AmilaChinthaka97/Analog-Line-Follower/Photos/IMG-20190604-WA0003.jpg

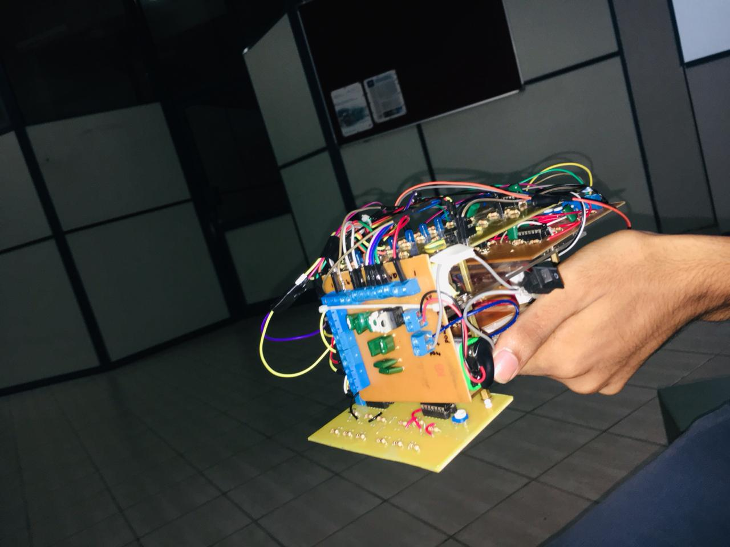
Photos/IMG-20190604-WA0003.jpg
