AmilaChinthaka97/Analog-Line-Follower/Photos/IMG-20190604-WA0004.jpg

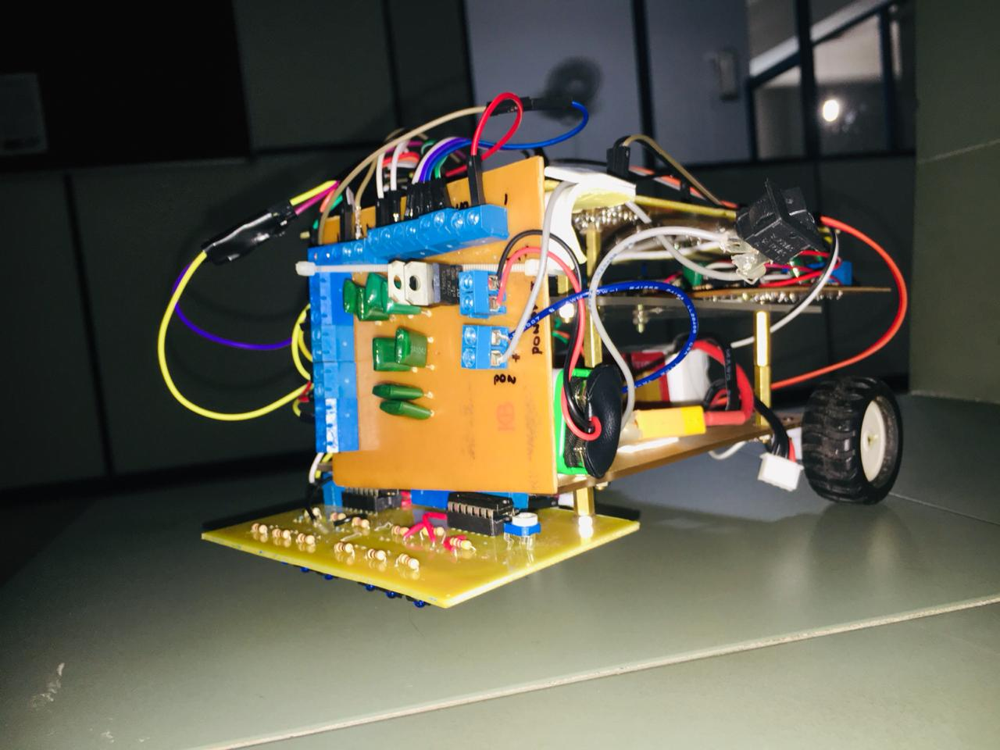
Photos/IMG-20190604-WA0004.jpg
