AmilaChinthaka97/Analog-Line-Follower/Photos/IMG-20190604-WA0016.jpg

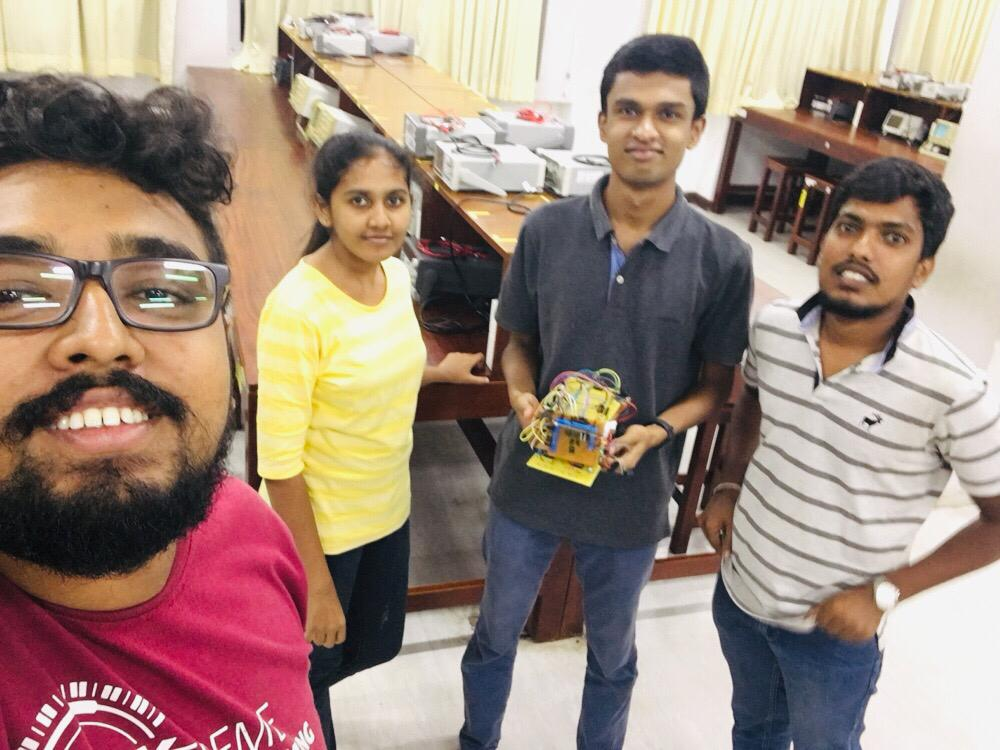
Photos/IMG-20190604-WA0016.jpg
