AmilaChinthaka97/Analog-Line-Follower/Photos/IMG-20190605-WA0002.jpg

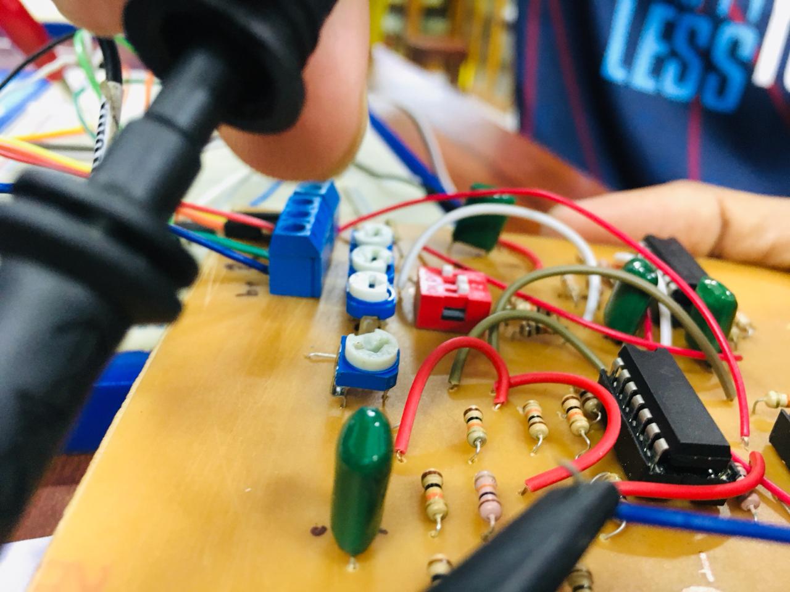
Photos/IMG-20190605-WA0002.jpg
