AmilaChinthaka97/Analog-Line-Follower/Photos/IMG-20190605-WA0006.jpg

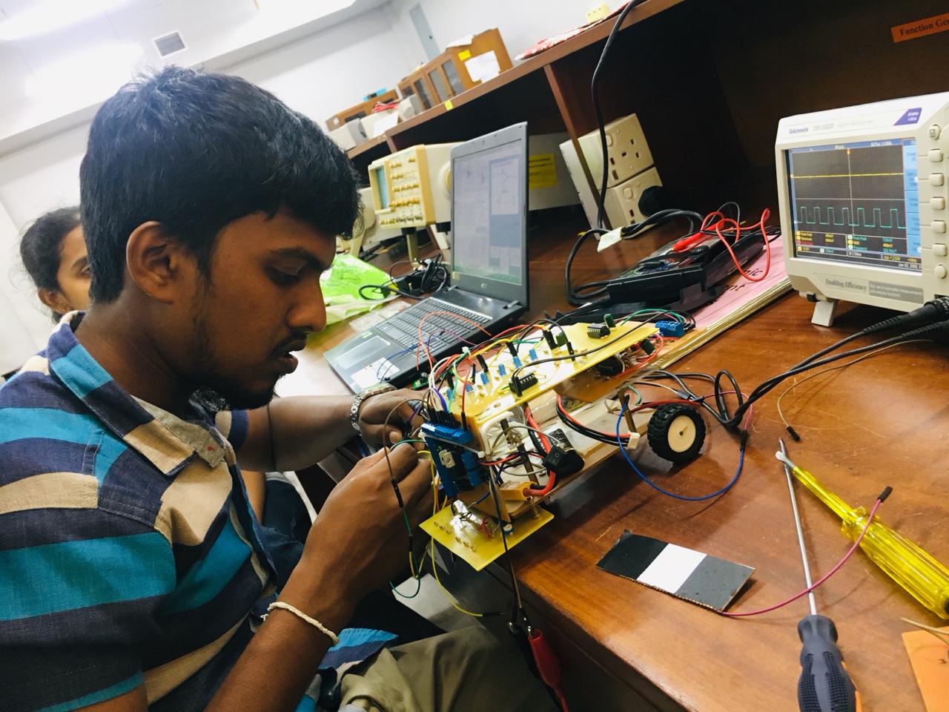
Photos/IMG-20190605-WA0006.jpg
