AmilaChinthaka97/Analog-Line-Follower/PCB Layouts/Error_TraingleWave.pdf

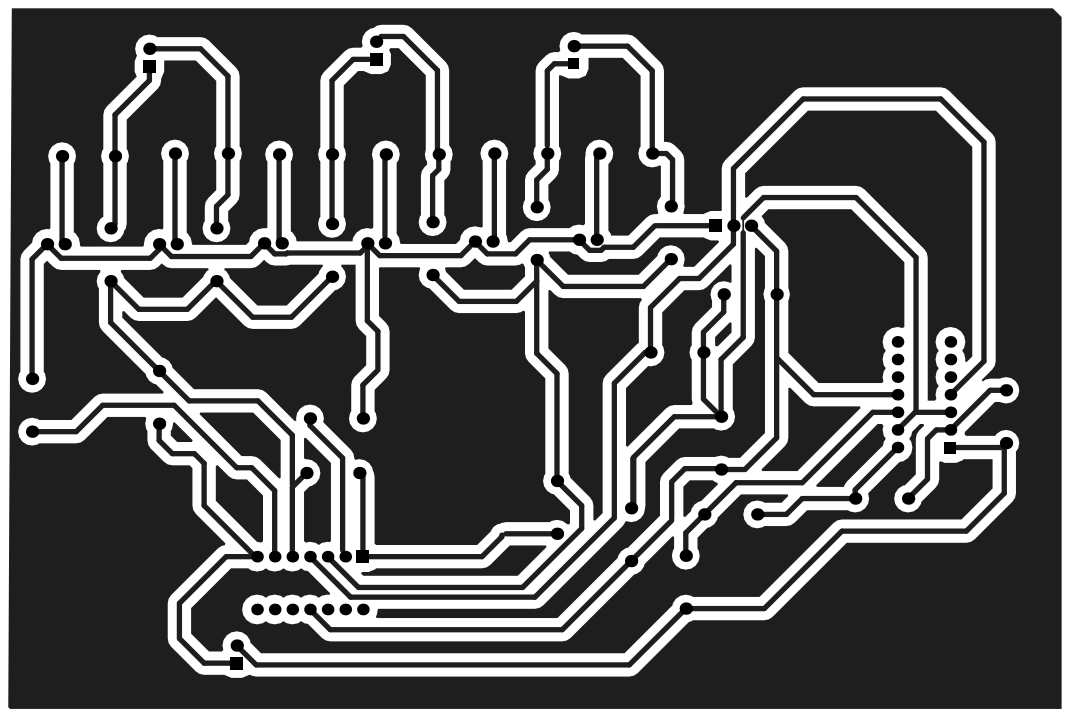
[picture p32: page 1]
