AmilaChinthaka97/Analog-Line-Follower/PCB Layouts/PID_All_New_Scaled.pdf

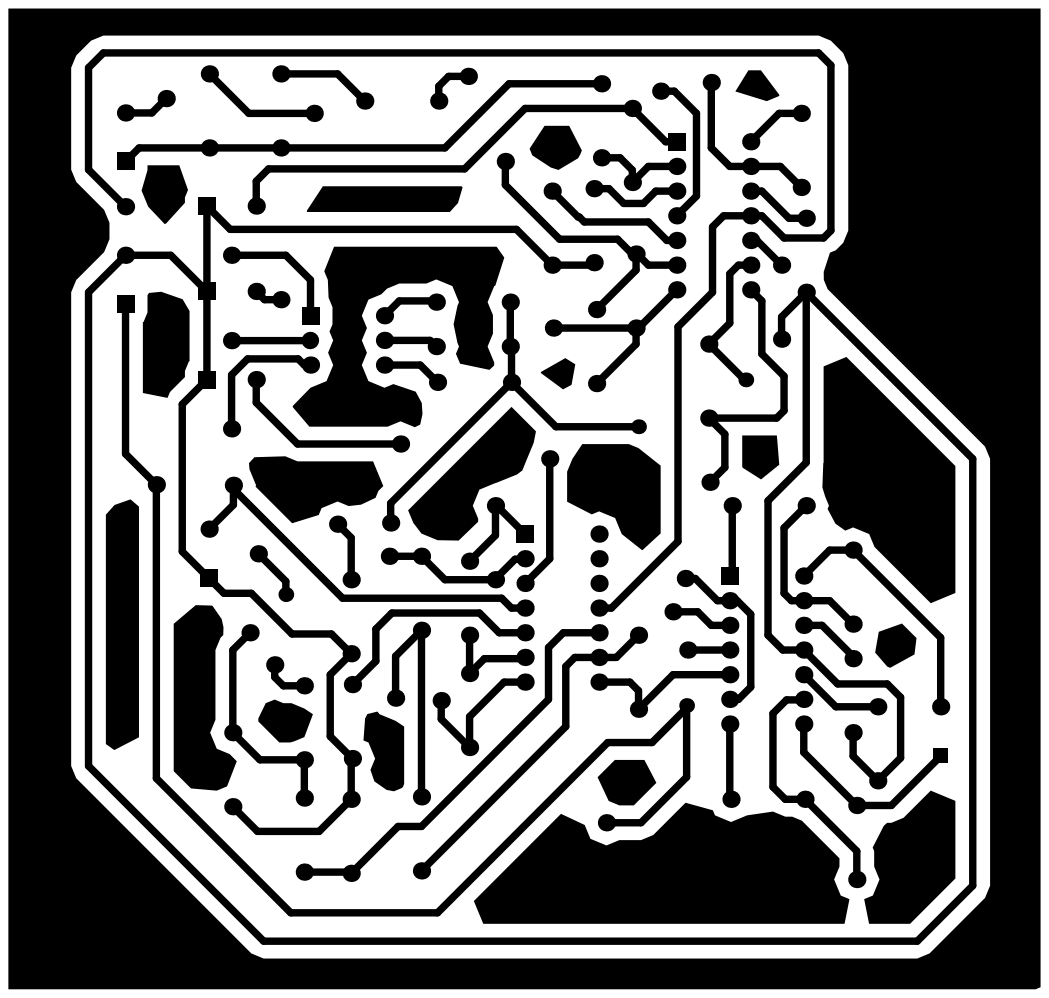
[picture p33: page 1]
