AmilaChinthaka97/Analog-Line-Follower/PCB Layouts/Power_Supply_With_Holes.pdf

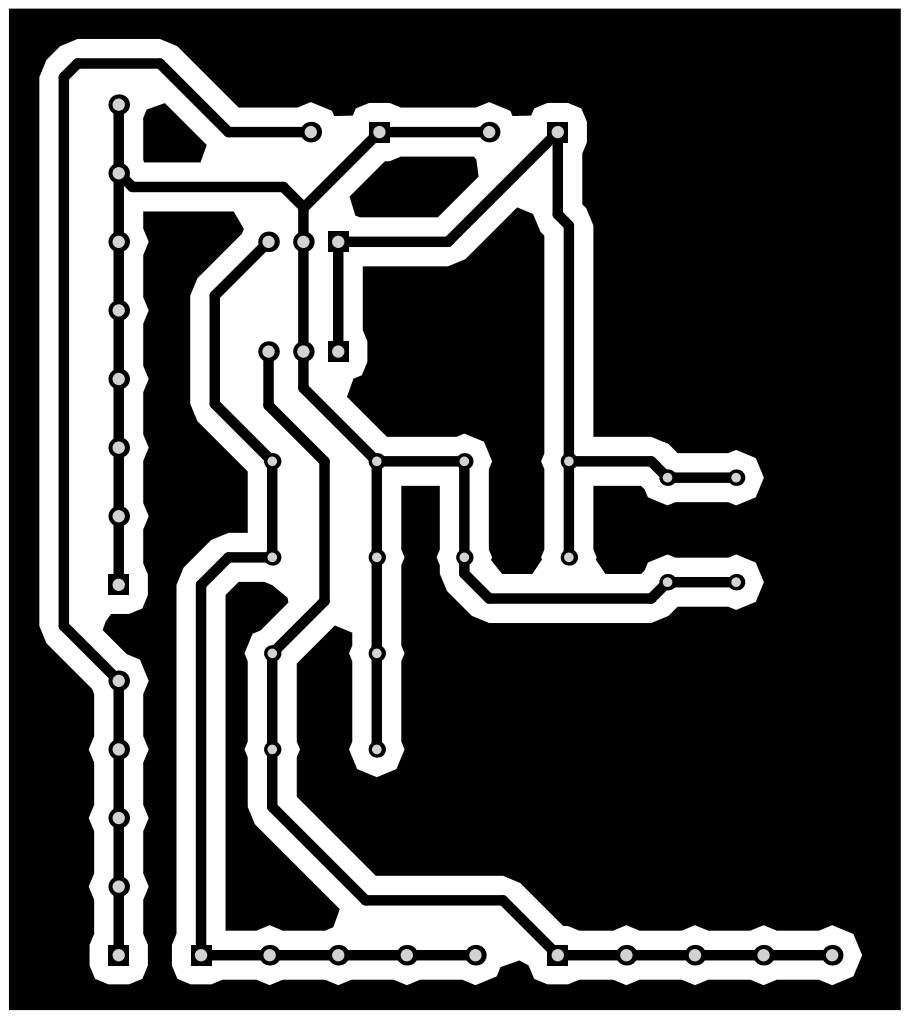
[picture p34: page 1]
