AmilaChinthaka97/Analog-Line-Follower/PCB Layouts/Sensor_Panel_Correct_Black_Scaled_Large_Pads_Correct_Footprints_new_Connectors_wITH_sTOP_cONDITION.pdf

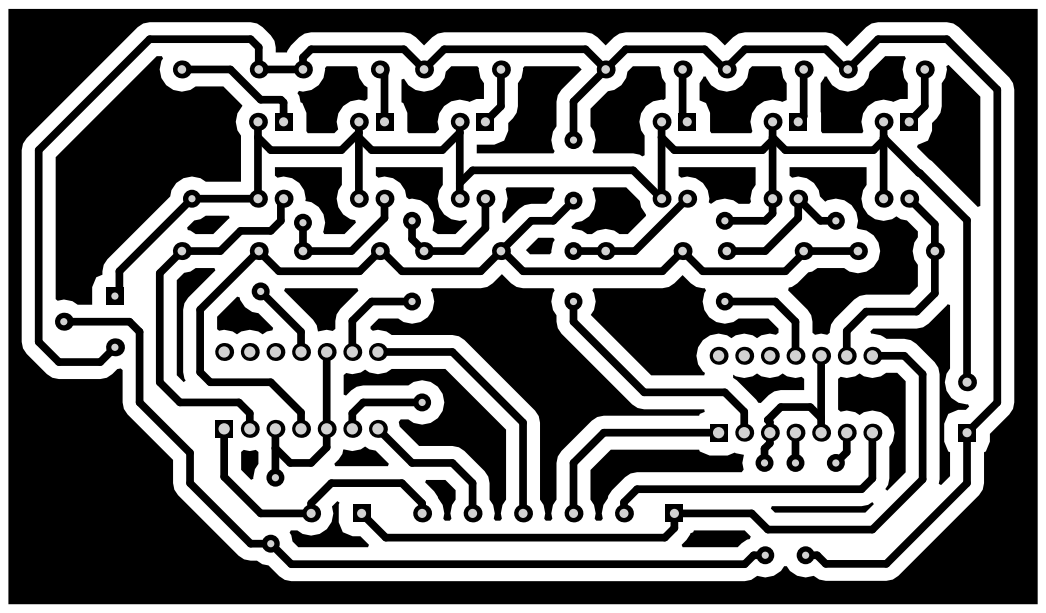
[picture p35: page 1]
