AmilaChinthaka97/Analog-Line-Follower/(list of files, drawings)

Other design files:
Altium Designer Files/PID_and_Motor_Driver/AT long bus (13.3 x 4.2 inches).PCBDOC
Altium Designer Files/PID_and_Motor_Driver/AT long bus (13.3 x 4.2 inches).schdoc
Altium Designer Files/PID_and_Motor_Driver/PID.PcbDoc
Altium Designer Files/PID_and_Motor_Driver/PID.SchDoc
Altium Designer Files/PID_and_Motor_Driver/PID_and_Motor_Driver.PrjPcb
Altium Designer Files/Power_Supply/AT long bus (13.3 x 4.2 inches).PCBDOC
Altium Designer Files/Power_Supply/AT long bus (13.3 x 4.2 inches).schdoc
Altium Designer Files/Power_Supply/Power_Supply.PcbDoc
Altium Designer Files/Power_Supply/Power_Supply.PrjPcb
Altium Designer Files/Sensor Panel/Sensor Panel.SchDoc
Altium Designer Files/Sensor Panel/Sensor.PcbDoc
Simulation Results/Ajeeth.ms14
Simulation Results/PID control cct.ms14
Simulation Results/PID.ms14
Simulation Results/PWM Single wheel.ms14
Simulation Results/PWM Test.ms14
Simulation Results/PWM.ms14
Simulation Results/SensorCct.ms14
Simulation Results/Trangular Wave.ms14
